RISC-NYUAD/Power_over_Tether/PoT-deliverable.pdf

## PoT-deliverable

This report is a list of the delivered files under the framework of the PREDATE Project.

- Under the PoT-Firmware folder, there are the following items:
- The PoT _FMW_GoPoS_V0_9 folder contains the latest firmware for the GoPoS MCU.
- The PoT _FMW_UAVPos_V0_7 folder contains the latest firmware for the UAVPoS MCU.
- PoT _Data_Storage_csv.py python script file, used for flight data logging on a PC.
- Under the PoT-Schematics folder, there are the following items:
- The PoT_Sch_GoPoS_V3_0 folder contains:
- The GoPoS schematics.
- The GoPoS PCB Document.
- The GoPoS PCB Gerber files.
- The GoPoS PCB Drill files.
- The GoPoS assembly pick and place files.
- The GoPoS PCB Bill of Materials.
- The PoT_Sch_UAVPoS_V2_0 folder contains:
- The UAVPoS schematics.
- The UAVPoS PCB Document.
- The UAVPoS PCB Gerber files.
- The UAVPoS PCB Drill files.
- The UAVPoS assembly pick and place files.
- The UAVPoS PCB Bill of Materials.
- Under the PoT-UART to ETHERNET CONVERTER Files there are the configuration files and the configuration program for the Uart-to-Ethernet converters used for the fiber optic communication.
- Under the PoT-Manual folder, there is the PoT Manual document.
