RISC-NYUAD/Power_over_Tether/PoT-UART to ETHERNET CONVERTER Files/drone_config.PNG

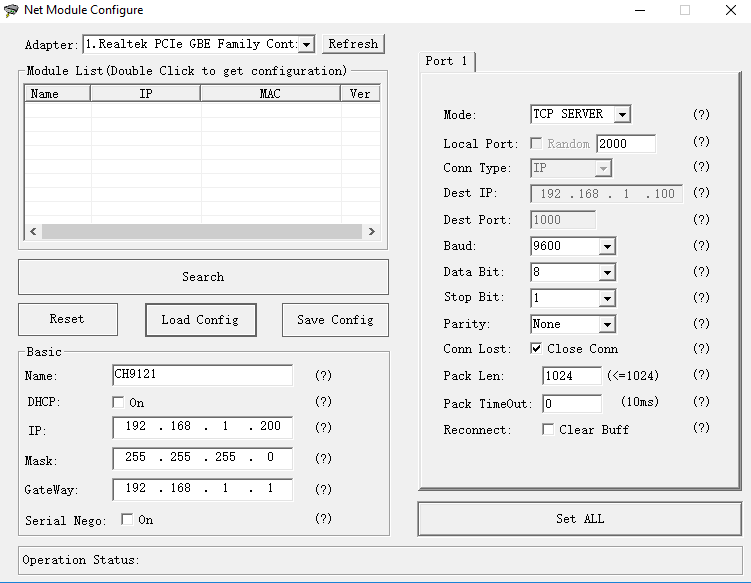
PoT-UART to ETHERNET CONVERTER Files/drone_config.PNG
