RISC-NYUAD/Power_over_Tether/PoT-UART to ETHERNET CONVERTER Files/gnd_config.PNG

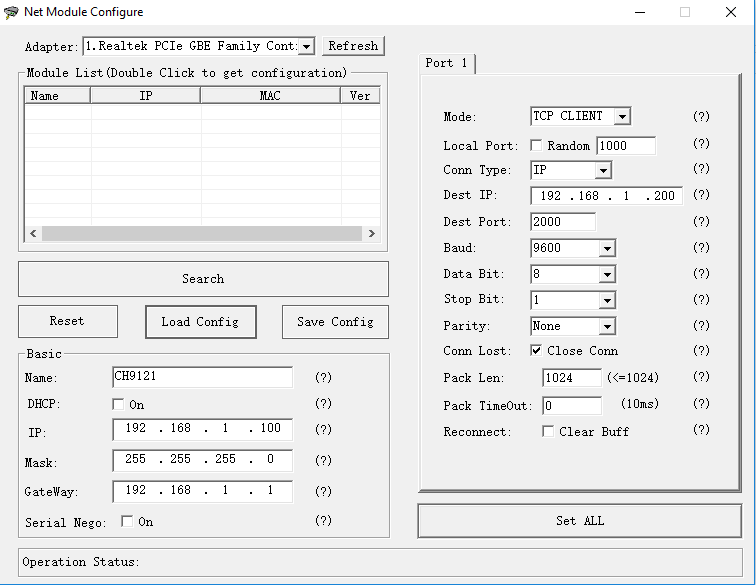
PoT-UART to ETHERNET CONVERTER Files/gnd_config.PNG
