RISC-NYUAD/Power_over_Tether/PoT-Schematics/PoT_Sch_GoPoS_V3_0/BOM/Bill of Materials-PREDATE_Ground_Station_V3_0.xlsx

Comment | Description | Designator | Footprint | LibRef | Quantity
0.1uF/25V | Multilayer Ceramic 25V 0.1uF X7R 0402 10% | C1, C2, C3, C4, C11, C27 | C0402 | C0402C104K3RACTU | 6
1uF/50V | CAP CER 1UF 50V X7R 0805 | C5 | C0805 | CL21B105KBFNNNE | 1
120uF/50V | Aluminium Electrolytic Capacitor, Wcap-Atg8 S | C6 | Cap_THT_O8mm | 860010674015 | 1
10uF/400V | Cap, 10UF, 400V, Alu Elec, Radial | C7, C12, C13, C14, C15, C16, C17, C18 | Cap_THT_O8mm | ESH106M400AH2AA | 8
10uF/16V | Multilayer Ceramic Capacitors MLCC - SMD/SMT | C8, C9, C10, C21 | C0805 | CL21A106KOQNNNE | 4
4.7uF/50V | CAP CER 4.7UF 50V X7R 1206 | C19, C20, C24, C25 | C1206 | CL31B475KBHNFNE | 4
0.01uF/25V | Multilayer Ceramic 25V 0.01uF X7R 0402 10% | C22, C23 | C0402 | C0402C103K3RAC7411 | 2
2.2uF/25V | Ceramic 2.2UF 25V 20% 0402 | C26 | C0402 | GRM155C81E225ME11D | 1
30-9506MF | Cable Assembly Data 3.048m 25 POS D-Sub to 25 | CB1 |  | 30-9510MF | 1
L717SDB25PA4CH4F | D-Sub Standard Connectors 25P Size B Stamped | CON1 | DSUB_THT_RIGHTAngle_25 | L717SDB25PA4CH4F | 1
1714971 | Terminal Block; 32 A; 690 V; 9.5 mm; 24 to 10 | CON2, CON3 | CON1X02_9.52mm | 1714971 | 2
881545-1 | NOVO Female Straight Black Handle, Open Top 2 | CON4, CON6 | Con1x02_2.54_Jump | 881545-1 | 2
M20-8770646 | 2.54MM M20 SMT Connectors 06 Sil Vertical SMT | CON5 | Con1x06_2.54 | M20-8770646 | 1
SMBJ20A | Diode TVS Single Uni-Dir 20V 600W 2-Pin SMB | D1 | DO-214AA-2 | SMBJ20A | 1
BAT54S,235 | DIODE ARRAY SCHOTTKY 30V SOT23 | D2, D3 | SOT-23-3 | BAT54S,235 | 2
S1M-HF | General Purpose Rectifier 1000V1A SMA (DO-214 | D4 | DO-214AC | S1M-HF | 1
0ADBP2000-RE | Fuses with Leads (Through Hole) FUSE, CERAMIC | F1 | Axial_Fuse_33mm | 0ADBP2000-RE | 1
MCP41010-I/SN | Digital Potentiometer 10k Ohm 1 Circuit 256 T | IC1 | SOIC-8 | MCP41010-I/SN | 1
MCA1101-5-3 | Open-drain, 16 Pin, Plastic/epoxy | IC2 | SOIC-16 | MCA1101-5-3 | 1
1.2mH/0.4A | Ind Power Shielded Wirewound 1.2mH 10% 1KHz 1 | L1 | L1208 | SRR1208-122KL | 1
744866103 | Filter, Common Mode, 0.01H, 3.4A | L2 | 744866103 | 744866103 | 1
6.8uH/0.3A | 1.6mm x 0.8mm x 0.8mm, -55 to +125 degC, 100m | L3, L4 | L0603 | MLZ1608M6R8WT000 | 2
1602A | LCD Character Display Modules & Accessories F | LCD1 | LCD_16x2 | 1602A | 1
150080GS75000 | Led, Green, 520 Nm, 3.2 V, 30 Ma, 450 Mcd Roh | LED1, LED2, LED3 | L0805 | 150080GS75000 | 3
STM32F407G-DISC1 | STM32F407VGT6 Microcontroller Development Kit | MCU1 | STM32F407G-DISC1 | STM32F407G-DISC1 | 1
RK7002BMT116 | N-Channel 60 V 0.2 W Surface Mount 2.5 V Driv | MOS1, MOS2 | SOT23-3-GSD | RK7002BMT116 | 2
Comment | Gigabit SFP to RJ45 Fiber Media Converter | PCB1 | TP-Link MC220L | TP-Link MC220L | 1
Uart to Ethernet Converter | The 2-CH UART TO ETH provides an easy way to | PCB2 | UART2ETH | 2-CH-UART-TO-ETH | 1
Potentiometer | Res Carbon Film POT 20K Ohm 20% 1/20W 1(Elec) | POT1 | Pot_THT | PTV09A-4030U-B203 | 1
PDSE1-S15-S5-S | 5 Vdc, 0.2 A, 1 W, 13.5~16.5 Vdc Input Range | PS1 | SIP-4 | PDSE1-S15-S5-S | 1
PV15-27B15R3 | DC DC Converter, 15V, 15W | PS2 | DIP-4_Module_1 | PV15-27B15R3 | 1
TS1117BCW33RP | LDO Regulator Pos 3.3V 1A 4-Pin(3+Tab) SOT-22 | PS3 | SOT-223-3 | TS1117BCW33RP | 1
PQP3-D12-D9-D | 9/-9 Vdc, 0.167/-0.167 A, 3 W, 9~18 Vdc Input | PS4 | DIP-5 | PQP3-D12-D9-D | 1
10K | Res General Purpose Thick Film 0402 10K Ohm 1 | R1, R9, R15, R34 | R0402 | RC0402FR-0710KL | 4
15K | Res SMD 0402 15K 1% 0.0625W T.C.100PPM | R2, R10, R12 | R0402 | RC0402FR-0715KL | 3
1K1 | RES SMD 1.1K OHM 1% 1/16W 0402 | R3, R5 | R0402 | RC0402FR-071K1L | 2
2K1 | Res Thick Film 0402 2.1K Ohm 1% 1/16W ±100ppm | R4, R6 | R0402 | RC0402FR-072K1L | 2
51k | Res 51K Ohm 0.1% 1/16W 0402 | R7 | R0402 | RN73R1ETTP5102B25 | 1
11.3k | Res Thin Film 0402 11.3K Ohm 0.1% 1/16W ±25pp | R8 | R0402 | RT0402BRD0711K3L | 1
10R | Res Thin Film 0402 10 Ohm 1% 0.063W(1/16W) ±5 | R11, R36 | R0402 | RT0402FRE0710RL | 2
24K | Res Thick Film 0402 24k Ohm 1% 1/16W ±100ppm/ | R13 | R0402 | RC0402FR-0724KP | 1
TBD |  | R14 | R0402 | Res0402_TBD | 1
2k2 | Res Thick Film 0402 2.2K Ohm 5% 1/16W ±100ppm | R16, R17, R18 | R0402 | RC0402JR-132K2L | 3
3k | Res Thin Film 0805 3K Ohm 1% 1/8W ±50ppm/°C M | R19, R42, R43 | R0805 | RT0805FRE073KL | 3
715R | Res Thin Film 0603 715 Ohm 1% 1/10W ±50ppm/°C | R20, R37 | R0603 | RT0603FRE07715RL | 2
1M | Res Thick Film 2010 1M Ohm 1% 0.5W(1/2W) ±100 | R21, R22, R23, R24, R25, R26, R27, R28 | R2010 | HV732HTTE1004F | 8
100R | Res Thin Film 0402 100 Ohm 1% 0.063W(1/16W) ± | R29, R32, R33, R35 | R0402 | RT0402FRE07100RL | 4
DNP |  | R30, R31 | R0603 | Res0603_TBD | 2
0R | AC Series 0402 0 Ohm JUMPER Thick Film Chip R | R38, R39, R40, R41 | R0402 | AC0402FR-070RL | 4
4682 | adafruit_microsd_spi_sdio 3V only | SD1 | SD_Board | 4682 | 1
PTS125SM43SMTR21M LFS | Tact Switch 12X12MM Vertical Typ | SW1, SW2, SW3 | 12mm_SMD | PTS125SM43SMTR21M LFS | 3
