RISC-NYUAD/Power_over_Tether/PoT-Schematics/PoT_Sch_UAVPoS_V2_0/BOM/Bill of Materials-PREDATE_inDrone_Top_V2_0.xlsx

Comment | Description | Designator | Footprint | LibRef | Quantity
CZ3706 | Current Sensor 58.3A 1 Channel Hall Effect, Open Loop Bidirectional 16-PowerSOIC (0.303", 7.70mm Width), 10 Leads | B1 | CZ3706 | CZ3706 | 1
4.7uF/50V | CAP CER 4.7UF 50V X7R 1206 | C1, C13, C41, C42, C59, C61 | C1206 | CL31B475KBHNFNE | 6
10uF/16V | Multilayer Ceramic Capacitors MLCC - SMD/SMT | C2, C5, C6, C14, C60 | C0805 | CL21A106KOQNNNE | 5
1uF/50V | CAP CER 1UF 50V X7R 0805 | C3 | C0805 | CL21B105KBFNNNE | 1
120uF/50V | Aluminium Electrolytic Capacitor, Wcap-Atg8 S | C4 | Cap_THT_O8mm | 860010674015 | 1
0.1uF/25V | Multilayer Ceramic 25V 0.1uF X7R 0402 10% | C7, C8, C9, C17, C20, C23, C24, C25, C26, C44, C45 | C0402 | C0402C104K3RACTU | 11
150uF/500V | Cap, 150UF, 500V, Alu Elec, Radial | C10, C11 | Cap_THT_O22mm-Lead10mm | ESG157M500AQ5AA | 2
10uF/100V | Cap Aluminum 10uF 100V 20% (6 X 11mm) Radial | C12 | Cap_THT_O6mm-Lead2.5mm | ESH106M100AE3AA | 1
3.3nF/25V | 0402 3.3 nF 25 V ±10 % Tolerance X7R SMT Mult | C15, C16, C18, C19 | C0402 | CC0402KRX7R8BB332 | 4
1nF/25V | Cap Ceramic 0.001uF 25V X7R 10% SMD 0402 125° | C21, C22, C27, C52, C53, C54, C55 | C0402 | AC0402KRX7R8BB102 | 7
10pF/25V | Cap Ceramic 10pF 25V C0G 2% Pad SMD 0402 125C | C28, C29, C30, C31 | C0402 | GRM1555C1E100GA01D | 4
0.01uF/25V | Multilayer Ceramic 25V 0.01uF X7R 0402 10% | C32, C33, C34 | C0402 | C0402C103K3RAC7411 | 3
1000pF/2kV | Cap Ceramic 0.001uF 2000V X7R 10% SMD 1808 12 | C35, C38, C39 | C1808 | GR442QR73D102KW01L | 3
2.2uF/100V | C Series 1812 2.2 uF 100 V ±10 % Tolerance X7 | C36, C37 | C1812 | C4532X7R2A225K230KA | 2
270pF/2kV | 1206 HV 270pF Ceramic Multilayer Cap; 2000Vdc | C40, C43 | C1206 | 1206GC271KAT1A | 2
2.2uF/25V | Ceramic 2.2UF 25V 20% 0402 | C46, C49, C50, C51 | C0402 | GRM155C81E225ME11D | 4
10uF/100V | Multilayer Ceramic Capacitors MLCC - SMD/SMT | C47, C48 | C1210 | GRM32EC72A106KE05L | 2
0.1uF/100V | CAP CER 0.1UF 100V X7R 0805 | C56, C57, C58 | C0805 | CL21B104KCFNNNE | 3
SSQ-110-01-T-S | Headers & Wire Housings Tiger Buy Socket Stri | CON1 | Con1x10_2.54 | SSQ-110-01-T-S | 1
22-28-4024 | Breakaway Header; KK 254; Vertical; 2 Circuit | CON2, CON3 | Con1x02_2.54 | 22-28-4024 | 2
1714971 | Terminal Block; 32 A; 690 V; 9.5 mm; 24 to 10 | CON9 | CON1X02_9.52mm | 1714971 | 1
 | Connector Accessories Wire End Ferrule With P | CON16, CON17 | ΧΤ150 | XT150 | 2
 | 2.50mm Pitch, Mini-Lock Female Crimp Terminal | CR1, CR2, CR3, CR4, CR5, CR6 |  | 0507528200 | 6
SMBJ20A | Diode TVS Single Uni-Dir 20V 600W 2-Pin SMB | D1 | DO-214AA-2 | SMBJ20A | 1
VS-80CPQ020-N3 | Diode Schottky Rectifier 20V 80A 3-Pin TO-247 | D2, D7, D8, D9 | TO-247 | VS-80CPQ020-N3 | 4
 | VT10200C-E3 10 A 200 V Trench MOS Barrier Sch | D3 | TO-220 | VT10200C-E3/4W | 1
BAT54S |  | D4, D5, D6 | sot-23-3 | BAT54S | 3
SZBZX84C18LT3G | SZBZX84C18L Series 18 V 225 mW 10 mA SMT Zene | DZ1 | SOT-23-3 | SZBZX84C18LT3G | 1
3574 | Adafruit Feather nRF52 Pro with myNewt Bootlo | F1, F2, F3 | 5AG_Holder | 3574 | 3
 | Fuse Chip Slow Blow Acting 1.6A 250V SMD Sold | F4 | fuse 1.6A 250V - duplicate | 3403.0168.11 | 1
3061295 | Fuse10.3x38 mm up to 1000 V DCgPVcharacterist | F5, F6, F7 |  | 3061295 | 3
0679L2500-05 | Fuse Brd Mnt 2.5A 125VAC/VDC | F8 | F2410 | 0679L2500-05 | 1
PF38281B1-000U-A99 | Fan; DC; 12V; 18.1CFM; 315A; 3.78W; 16000RPM; | FAN1, FAN2, FAN3 |  | PF38281B1-000U-A99 | 3
43807-09 | Heat Sink For Dcdc Cnvtr/arrays | HS1, HS2, HS3 |  | 43807-09 | 3
LMV981MG/NOPB | Op Amp Single Low Voltage Amplifier R-R I/O 5 | IC1, IC3, IC4, IC5 | SC-70-6 | LMV981MG/NOPB | 4
CZ3AG5 | Current Sensor 58.3A 1 Channel Hall Effect, Open Loop Bidirectional 16-PowerSOIC (0.303", 7.70mm Width), 10 Leads | IC6 | CZ3AG5 | CZ3AG5 | 1
MC33161DR2G | Supervisor Open Drain or Open Collector 2 Cha | IC7 | SOIC-8 | MC33161DR2G | 1
XT150 |  | J1, J2, J3, J4 | XT150 | XT150 | 4
TCK-075 | Common Mode Chokes Dual 33.3uH 100kHz 4A 0.00 | L1 | TCK-075 | TCK-075 | 1
TCK-076 | COMMON MODE CHOKE, 55UH, 5.7A; Product Range: | L2 | TCK-075 | TCK-076 | 1
6.8uH/0.3A | 1.6mm x 0.8mm x 0.8mm, -55 to +125 degC, 100m | L3, L4 | L3 | MLZ1608M6R8WT000 | 2
6.8uH/0.3A | 1.6mm x 0.8mm x 0.8mm, -55 to +125 degC, 100m | L5 | L0603 | MLZ1608M6R8WT000 | 1
150080GS75000 | Led, Green, 520 Nm, 3.2 V, 30 Ma, 450 Mcd Roh | LED1, LED2, LED3, LED6, LED7 | L0805 | 150080GS75000 | 5
150141RV73100 | Led, Green, Red, R 250Mcd, G 60Mcd, 120 , R 2 | LED4, LED5 | 3528_metric | 150141RV73100 | 2
V625LA40AP | LA Series 825 VDC 625 V RMS 1650 V Clamp 4500 | M1, M2, M3 | V625LA40AP | V625LA40AP | 3
STM32F407G-DISC1 | STM32F407VGT6 Microcontroller Development Kit | MCU1 | STM32F407G-DISC1 | STM32F407G-DISC1 | 1
RK7002BMT116 | N-Channel 60 V 0.2 W Surface Mount 2.5 V Driv | MOS1, MOS2, MOS3, MOS4 | SOT23-3-GSD | RK7002BMT116 | 4
CSD19535KCS | 100-V, N channel NexFET™ power MOSFET, single | MOS5 | TO-220-AB | CSD19535KCS | 1
Comment | Description | PCB1 | ADUM3221ARZ_Breakout | ADUM3221ARZ_Breakout | 1
Uart to Ethernet Converter | The 2-CH UART TO ETH provides an easy way to | PCB2 | uart2ethernet | 2-CH-UART-TO-ETH | 1
Comment | Gigabit SFP to RJ45 Fiber Media Converter | PCB3 | TP-Link MC220L | TP-Link MC220L | 1
PDSE1-S12-S5-S | 5 Vdc, 0.2 A, 1 W, 10.8~13.2 Vdc Input Range | PS1, PS4 | SIP-4 | PDSE1-S12-S5-S | 2
TEN30-4812 | Module DC-DC 48VIN 1-OUT 12V 25A 30W 6-Pin | PS2 | 2''_x_1'' | TEN30-4812 | 1
TS1117BCW33RP | LDO Regulator Pos 3.3V 1A 4-Pin(3+Tab) SOT-22 | PS3 | SOT-223-3 | TS1117BCW33RP | 1
PQP3-D12-D9-D | 9/-9 Vdc, 0.167/-0.167 A, 3 W, 9~18 Vdc Input | PS5 | DIP-5 | PQP3-D12-D9-D | 1
715R | Res Thin Film 0603 715 Ohm 1% 1/10W ±50ppm/°C | R1, R19, R43, R44, R45, R46, R47, R70 | R0603 | RT0603FRE07715RL | 8
3k | Res Thin Film 0805 3K Ohm 1% 1/8W ±50ppm/°C M | R2 | R0805 | RT0805FRE073KL | 1
2k2 | Res Thick Film 0402 2.2K Ohm 5% 1/16W ±100ppm | R3, R4, R5, R48, R50, R51, R52 | R0402 | RC0402JR-132K2L | 7
0R | AC Series 0402 0 Ohm JUMPER Thick Film Chip R | R6, R8, R9, R10, R12, R13, R60 | R0402 | AC0402FR-070RL | 7
1k87 | Res Thick Film 0402 1.87K Ohm 1% 1/16W ±100pp | R7 | R0402 | CR0402-FX-1871GLF | 1
2K8 | Res Thick Film 0402 2.8K Ohm 1% 1/16W ±100ppm | R11 | R0402 | RC0402FR-072K8L | 1
3K92 | Res Thick Film 0402 3.92K Ohm 1% 1/16W ±100pp | R14 | R0402 | CRCW04023K92FKED | 1
1M | Res Thick Film 2010 1M Ohm 1% 0.5W(1/2W) ±100 | R15, R16 | R2010 | HV732HTTE1004F | 2
3K16 | Res Thin Film 0603 3.16K Ohm 1% 1/10W ±50ppm/ | R17, R18 | R0402 | MCT06030C3161FP500 | 2
3k6 | Res Thick Film 0402 3.6K Ohm 1% 0.063W(1/16W) | R20 | R0402 | RC0402FR-073K6L | 1
1k4 | Res General Purpose Thick Film 0402 1.4K Ohm | R21, R24, R30, R31, R36 | R0402 | RC0402FR-071K4L | 5
4k12 | RES SMD 4.22K OHM 1% 1/16W 0402 | R22 | R0402 | RC0402FR-074K22L | 1
845R | Res Thick Film 0402 845 Ohm 1% 1/16W ±100ppm/ | R23 | R0402 | RC0402FR-07845RL | 1
100k/0.1% | RES SMD 100K OHM 0.1% 1/10W 0603 | R25 | R0402 | RT0603BRD07100KL | 1
604R/0.1% | Res Thin Film 0402 604 Ohm 0.1% 1/16W ±25ppm/ | R26 | R0402 | RT0402BRD07604RL | 1
374R/0.1% | Res Thin Film 0603 374 Ohm 0.1% 1/10W ±25ppm/ | R27 | R0402 | RT0603BRD07374RL | 1
2K | Res General Purpose Thick Film 0402 2K Ohm 1% | R28, R29, R32, R34, R35 | R0402 | RC0402FR-072KL | 5
1K02 | Res Thick Film 0402 1.02K Ohm 1% 1/16W ±100pp | R33, R69 | R0402 | RC0402FR-071K02L | 2
100R | Res Thin Film 0402 100 Ohm 1% 0.063W(1/16W) ± | R37, R38, R39, R40, R41, R42, R64, R65, R66 | R0402 | RT0402FRE07100RL | 9
10R | Res Thin Film 0402 10 Ohm 1% 0.063W(1/16W) ±5 | R49, R53, R54, R55, R63 | R0402 | RT0402FRE0710RL | 5
43k/0.1% | Res Thin Film 0805 43K Ohm 0.1% 1/8W ±25ppm/° | R56 | R0805 | RT0805BRD0743KL | 1
3K16 | Res Thin Film 0603 3.16K Ohm 1% 1/10W ±50ppm/ | R57 | R0603 | MCT06030C3161FP500 | 1
TBD |  | R58, R61 | R0402 | Res0402_TBD | 2
1k/0.1% | Res Thin Film 0805 1K Ohm 0.1% 0.125W(1/8W) + | R59 | R0805 | ERA-6AEB102V | 1
Through Hole MPT35 27R 1% |  | R62 | Through Hole MPT35 27R 1% | Through Hole MPT35 27R 1% | 1
3k |  | R67, R68 | 0805_3k | 3k | 2
 | Tact Switch 12X12MM Vertical Typ | SW1, SW2, SW3 | 12mm_SMD | PTS125SM43SMTR21M LFS | 3
bcm4414 |  | U2, U3, U4 | BCM4414 | bcm4414bh0e5035m10 | 3
