RISC-NYUAD/Power_over_Tether/PoT-Schematics/PoT_Sch_GoPoS_V3_0/GoPoS_v3.pdf

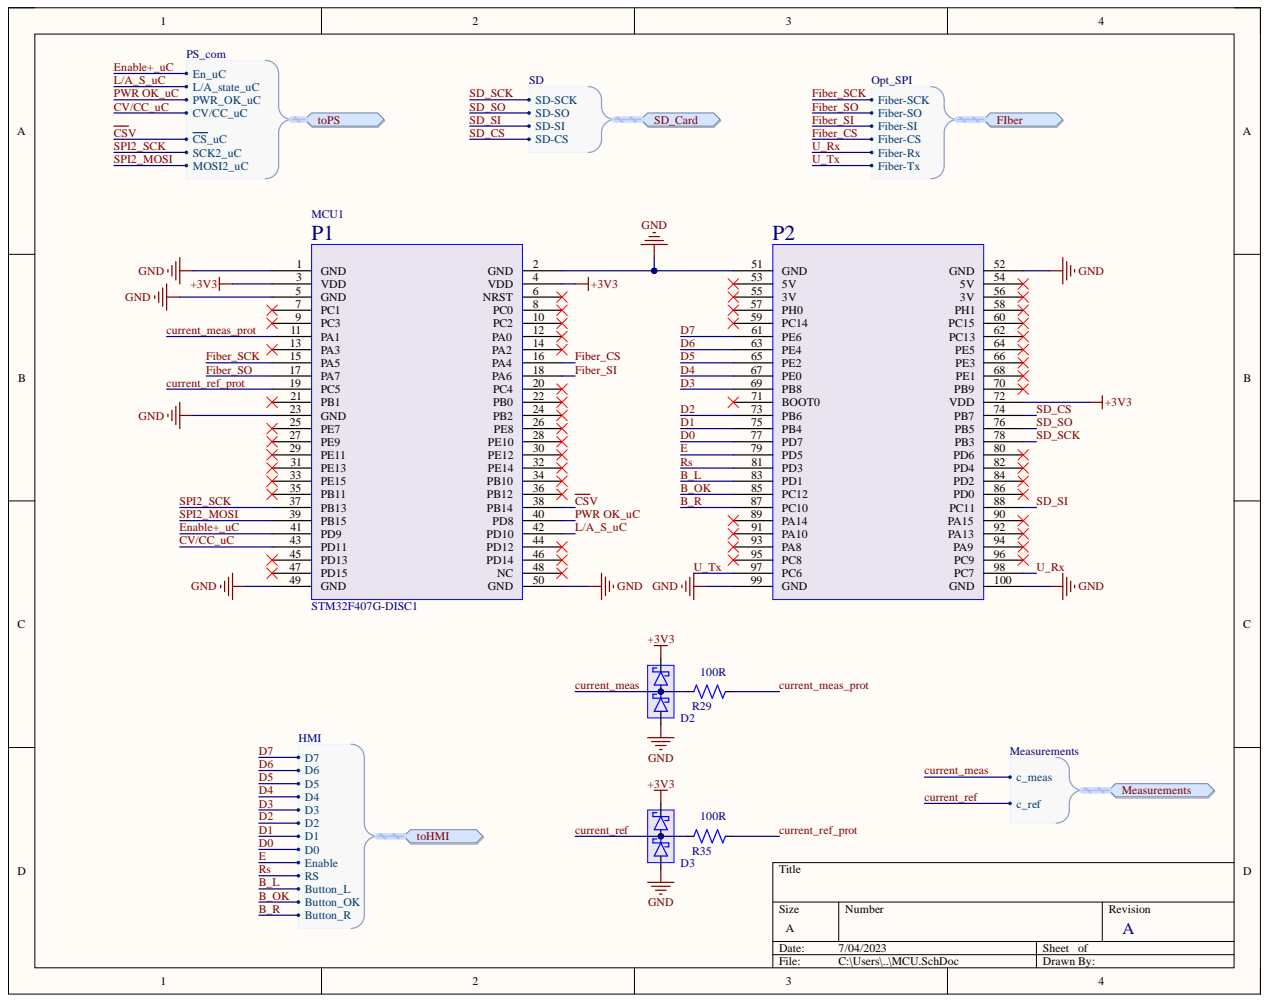
[picture p13: page 1]

Size A | Number | Revision

Date: 7/04/2023 | Sheet of
File: C:\Users\..\MCU.SchDoc | Drawn By:

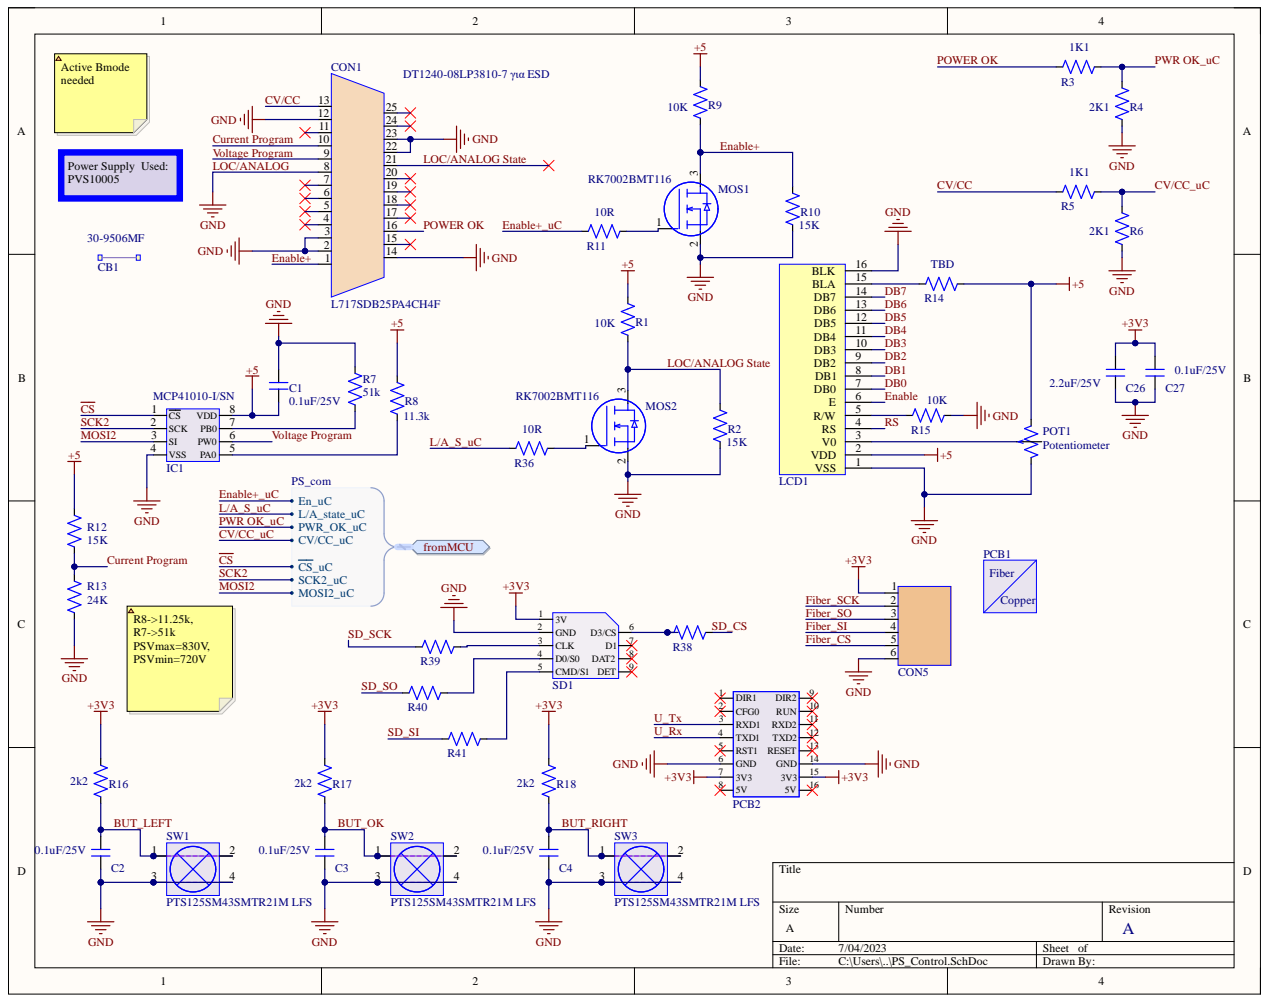
[picture p14: page 2]

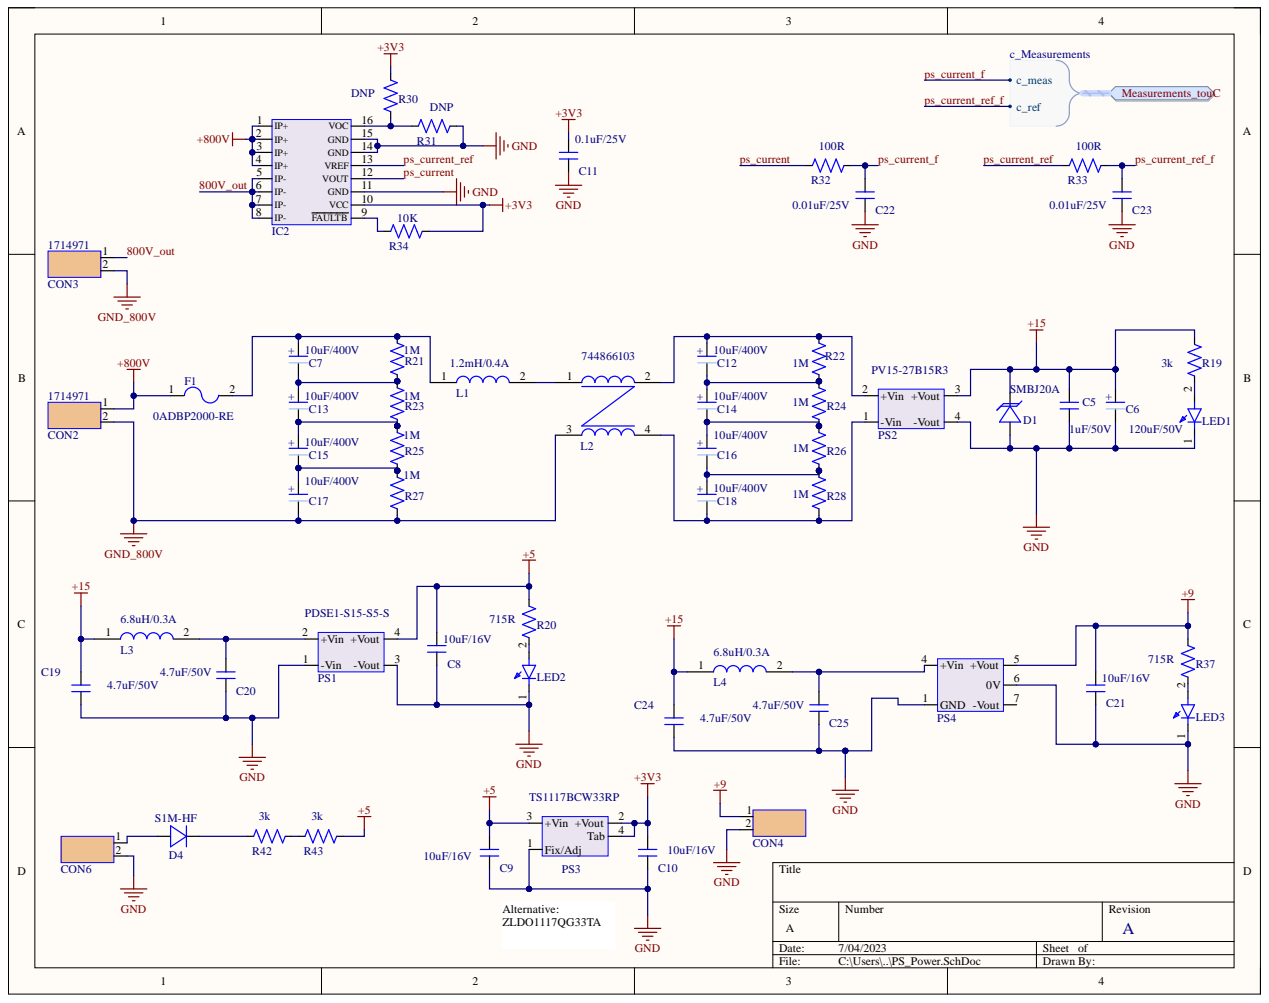
[picture p15: page 3]
