RISC-NYUAD/Power_over_Tether/PoT-Schematics/PoT_Sch_UAVPoS_V2_0/UAVPoS_v2.pdf

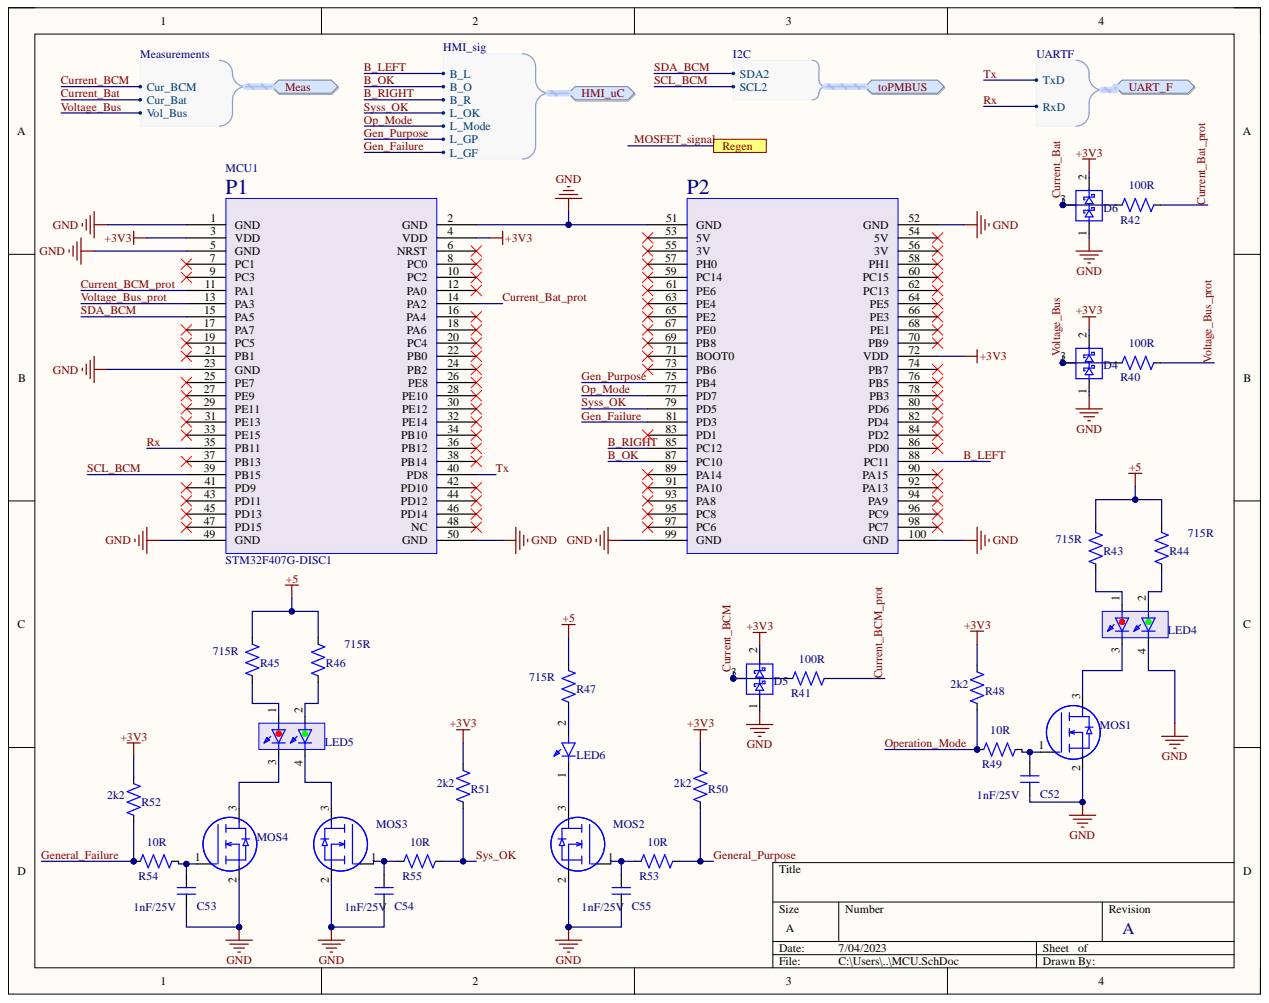
[picture p16: page 1]

PE9 27 | Op_Mode
PE11 29 | Syss_OK
PE13 31 | Gen_Failure
PE15 33 | B_RIGHT

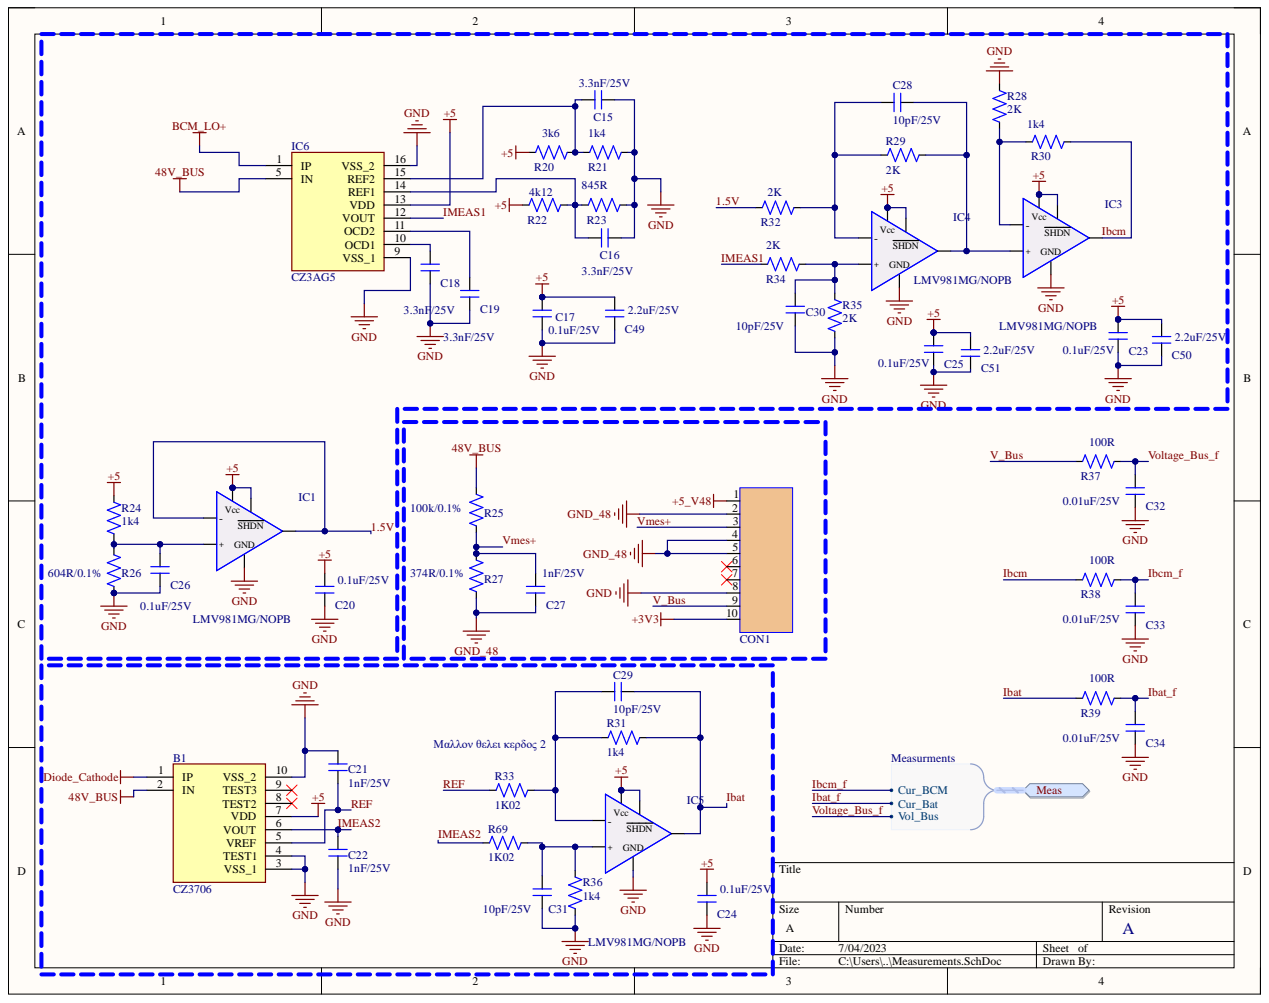
[picture p17: page 2]

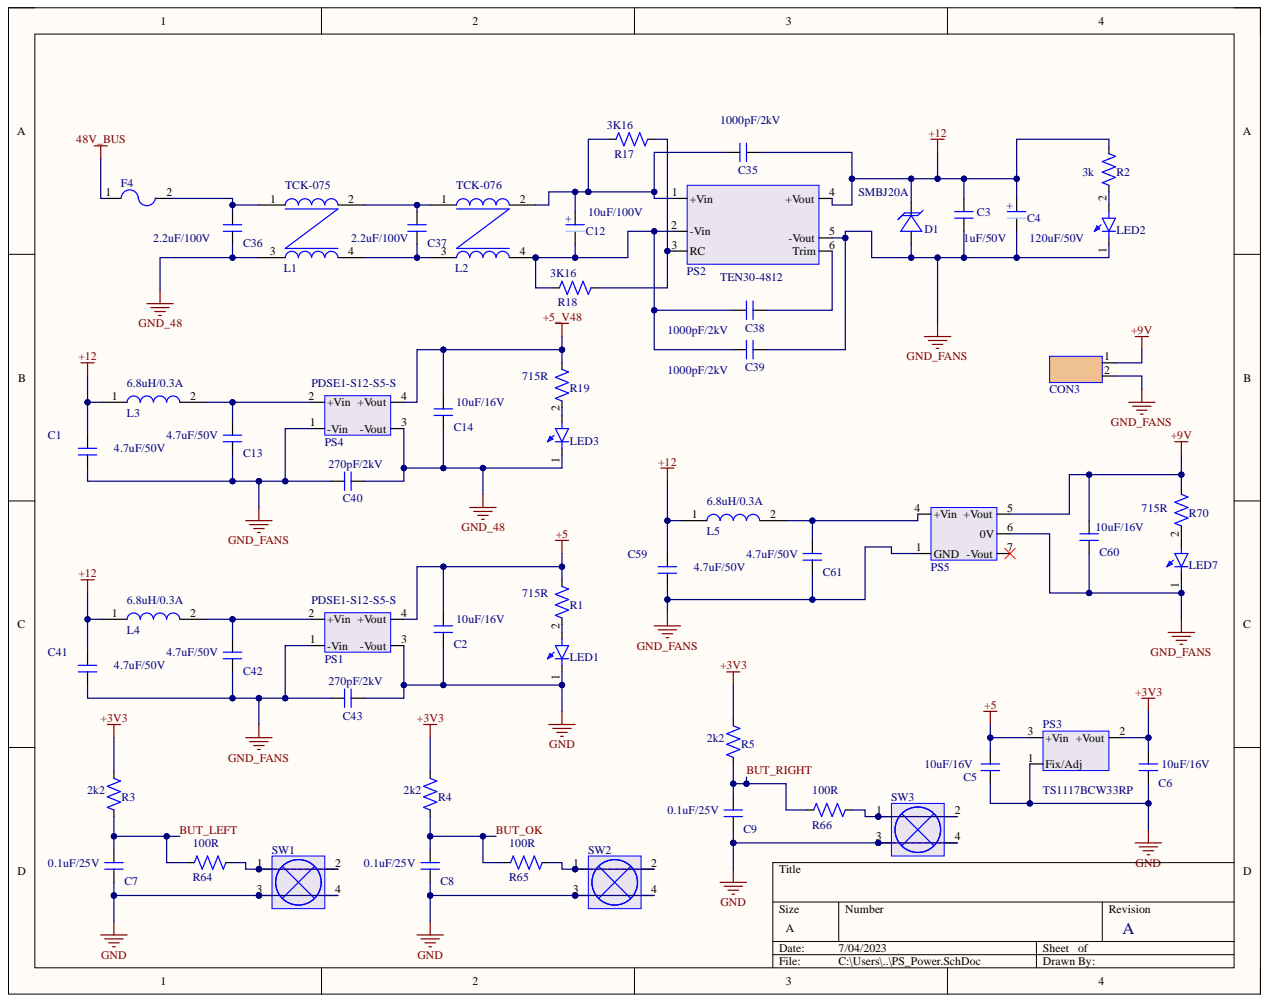
[picture p18: page 3]

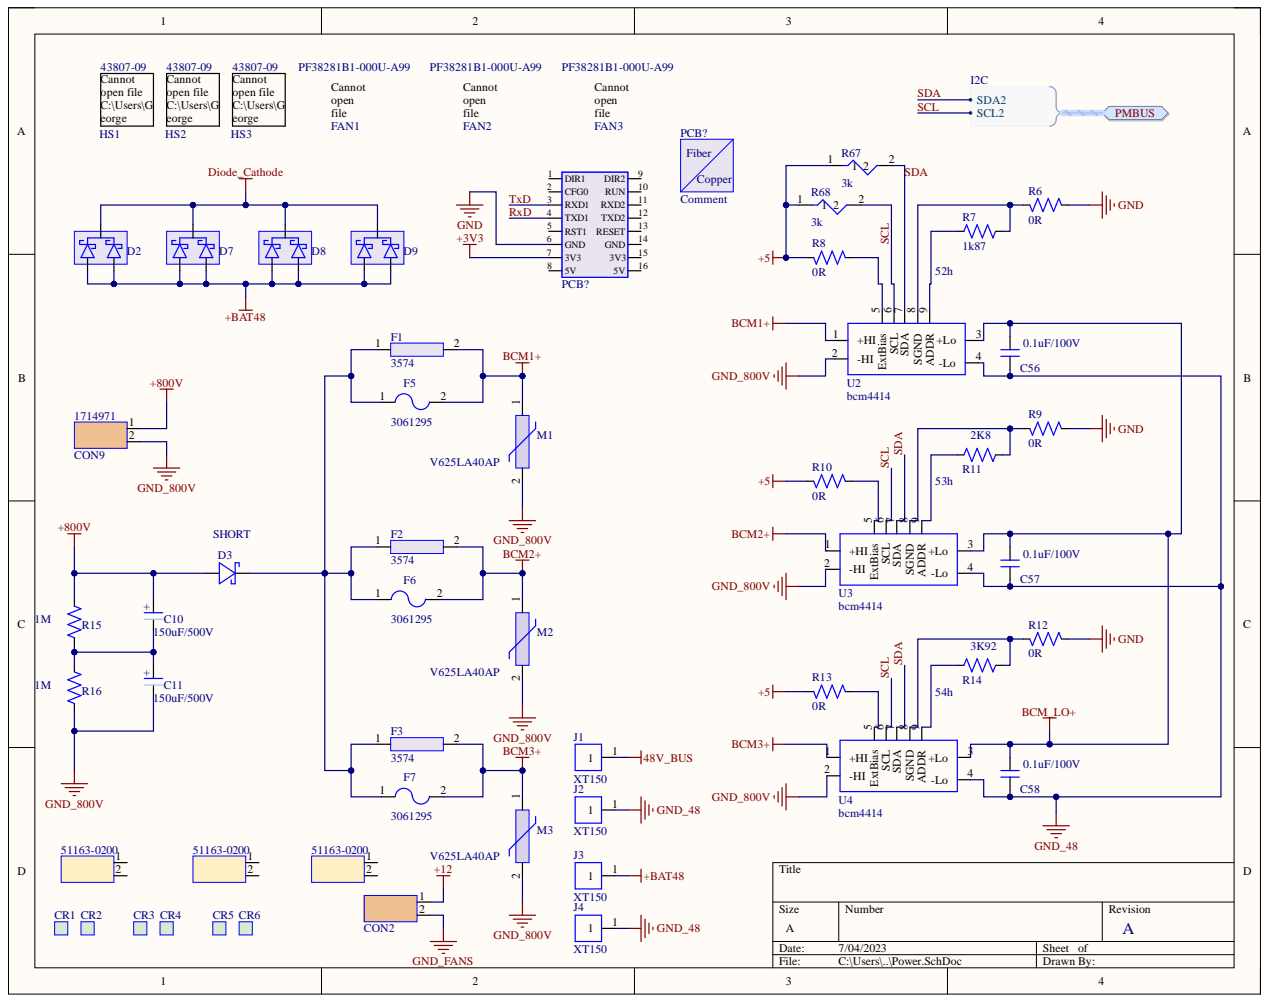
[picture p19: page 4]

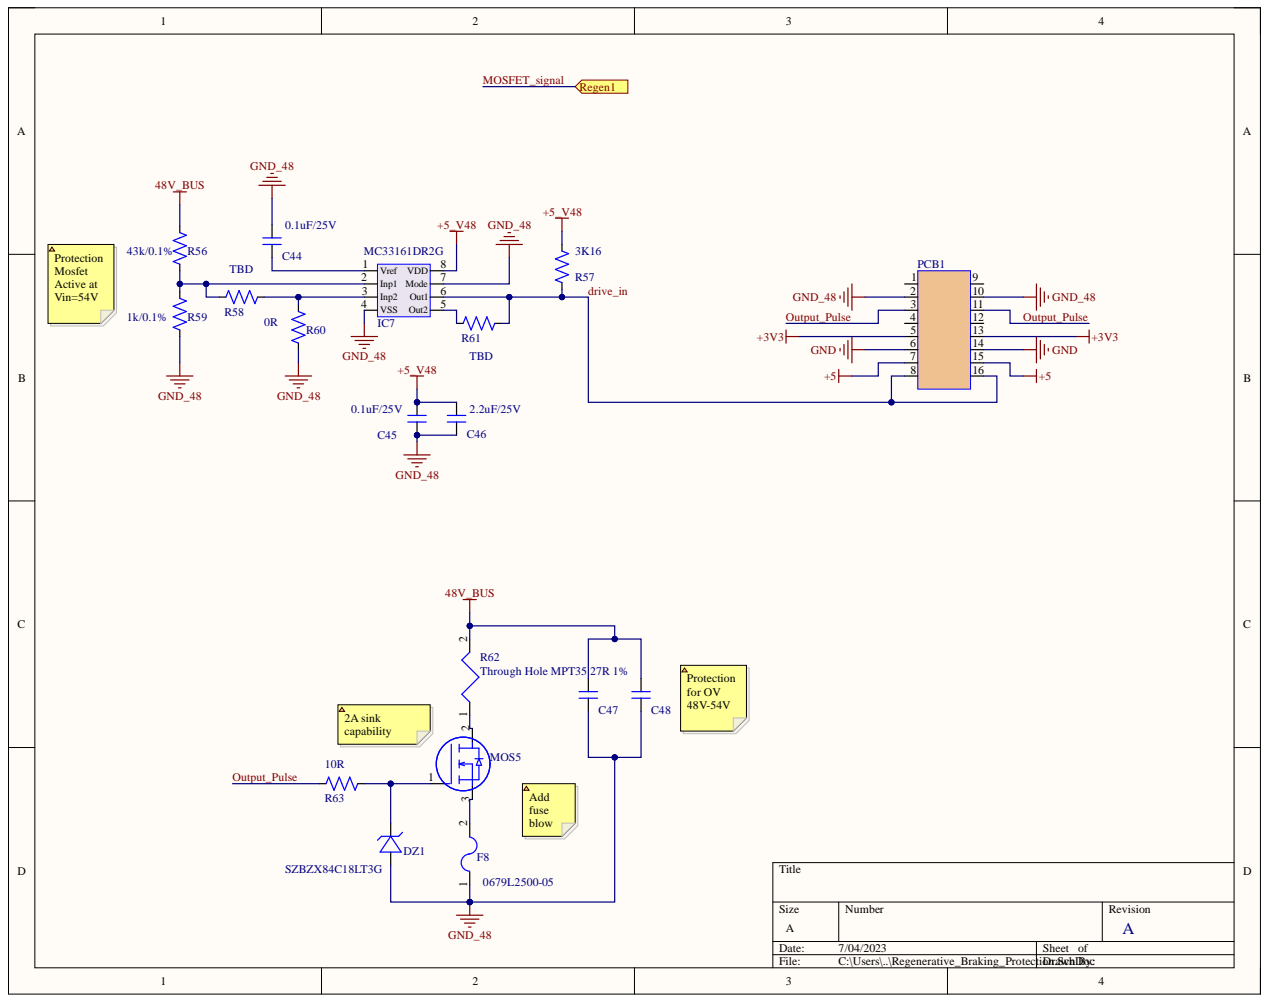
[picture p20: page 5]

Output_Pulse | 4 | | 12 | Output_Pulse

6 | | 14
7 | | 15
8 | | 16
